supermileage/UrbanMotorControllerPCB/Urban MC.step

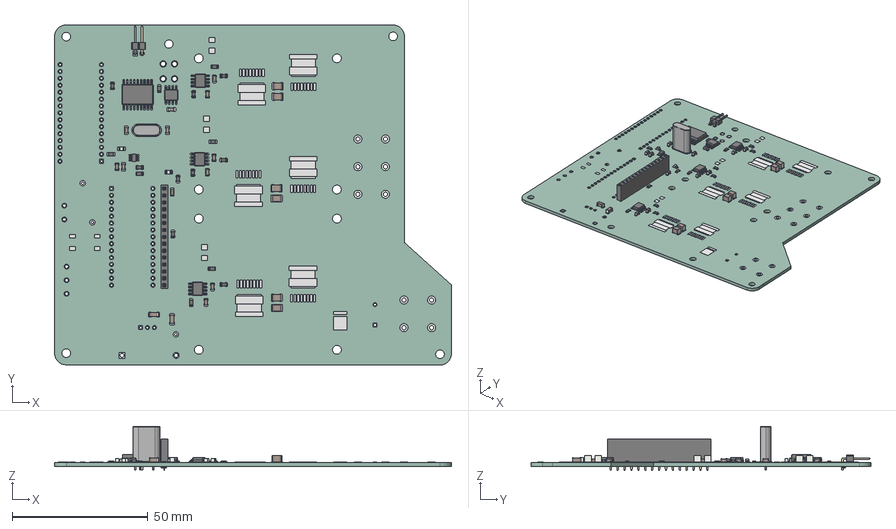
[picture p1: CAD file, 2026-01-06]
Urban MC.step
146.1 x 125.2 x 16.2 mm
C_0805_2012Metric x 12
R_0805_2012Metric x 17
Crystal_HC49-U_Vertical
C_1210_3225Metric x 6
PinHeader_1x02_P2.54mm_Horizontal
SOIC-8_3.9x4.9mm_P1.27mm x 4
SOIC-18W_7.5x11.6mm_P1.27mm
PinSocket_1x15_P2.54mm_Vertical
LED_0805_2012Metric x 2
C_1206_3216Metric x 2
SOT-23-6
Urban MC_pad
Urban MC_PCB
