supermileage/UrbanMotorControllerPCB/Urban MC.kicad_pcb

## KiCad design Urban MC.kicad_pcb (2026-10-03)

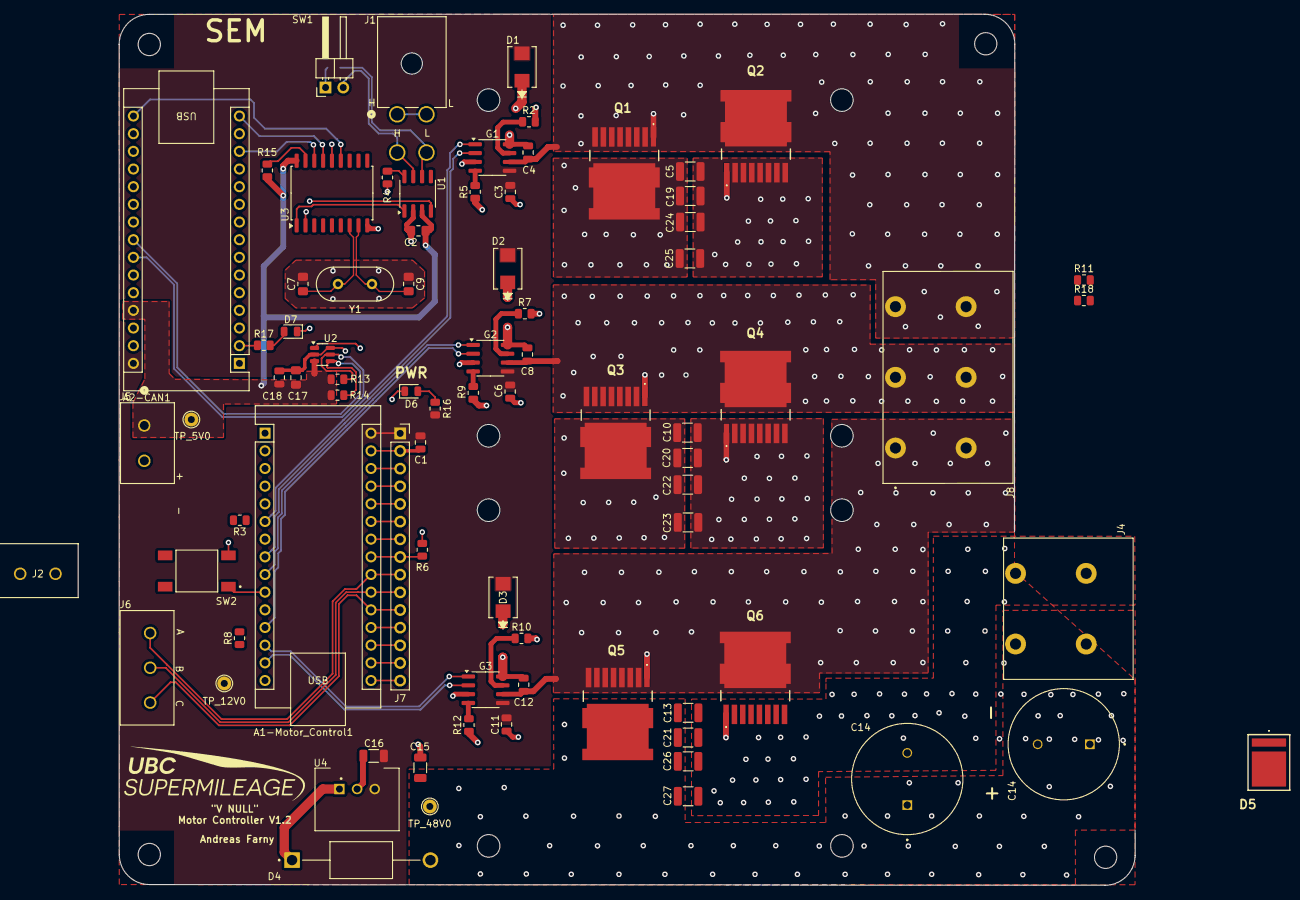
[picture p2: board Urban MC.kicad_pcb from above]

Board: 6 copper layers, 146.1 x 125.2 mm, 83 parts (1 on the bottom side), 66 nets.

Parts:
A1-Motor_Control1, A2-CAN1: Arduino_Nano_v2.x; Arduino_Nano
C1, C3, C6, C8, C11, C12, C18: 10u; C_0805_2012Metric
C2, C17: 0.1uF; C_0805_2012Metric_Pad1.18x1.45mm_HandSolder
C4: 1u; C_0805_2012Metric
C5, C10, C13: 100 nF; C_1210_3225Metric
C7, C9: 16pF; C_0805_2012Metric_Pad1.18x1.45mm_HandSolder
C14, C14#2: 1m; CAPPRD750W80D1600H2500
C15: 1u; C_1206_3216Metric
C16: 22u; C_1206_3216Metric
C19, C20, C21: 1 uF; C_1210_3225Metric
C22, C24, C26: 4.7 uF; C_1210_3225Metric
C23, C25, C27: 10 uF; C_1210_3225Metric
D1, D2, D3: D; DIODE_DO214AA_MBRS_VIS
D4: D; DIOAD1990W125L900D530
D5: D_TVS; PTVS1058CH
D6, D7: LED; LED_0805_2012Metric
G1, G2, G3: IRS2186; SOIC-8_3.9x4.9mm_P1.27mm
HEATSINK: HEATSINK-518-95AB
HEATSINK#2: HEATSINK-518-95AB
J1: CAN; CONN_5569-04A_MOL
J2: UART_DYNO; CONN_OSTTC022162_OST
J4: VBAT; TE_1-1986660-2
J5: PWR_HALL; CONN_OSTTC022162_OST
J6: HALL_SENSORS; CONN_OSTTC030162_OST
J7: Conn_01x15_Socket; PinSocket_1x15_P2.54mm_Vertical
J8: Conn_02x03_CUSTOM; TE_1986660-3
Q1, Q2, Q3, Q4, Q5, Q6: NTBLS0D8N08XTXG; NVBLS1D1N08H
R1: 120; R_0805_2012Metric
R2, R5, R7, R9, R10, R12: 11Ω; R_0805_2012Metric
R3, R8, R11, R18: 0Ω; R_0805_2012Metric
R4, R15: 10k; R_0805_2012Metric
R6, R13, R14: 10K; R_0805_2012Metric
R16: 4.7k; R_0805_2012Metric
R17: 1.5k; R_0805_2012Metric
SW1: CAN_TERM; PinHeader_1x02_P2.54mm_Horizontal
SW2: SW_MEC_5E; SW_TS04-66-70-BK-160-SMT
TP_5V0, TP_12V0, TP_48V0: TestPoint; TestPoint_THTPad_D2.0mm_Drill1.0mm
U1: MCP2561/2; SOIC-8_3.9x4.9mm_P1.27mm
U2: MCP4725; SOT-23-6
U3: MCP2515-xSO; SOIC-18W_7.5x11.6mm_P1.27mm
U4: CONV_LCW78_12-1.0
Y1: 8MHz; Crystal_HC49-U_Vertical

Connections:
3.3V_OUT: A1-Motor_Control1.17 (3V3), J7.14
5V_OUT: A1-Motor_Control1.27 (+5V), J7.4
+5V: A2-CAN1.27 (+5V), C2.2, C17.1, C18.1, J5.1, R13.1, R14.1, R15.2, TP_5V0.1, U1.3 (VDD), U2.3 (VDD), U3.18 (VDD)
+12V: A1-Motor_Control1.30 (VIN), A2-CAN1.30 (VIN), C1.1, C3.2, C6.2, C11.2, C16.2, D1.2, D2.2, D3.2, G1.5 (VCC), G2.5 (VCC), G3.5 (VCC), J7.1, R16.1, TP_12V0.1, U4.3 (+VOUT)
+48V: C5.1, C10.1, C13.1, C14.1, C15.1, C19.1, C20.1, C21.1, C22.1, C23.1, C24.1, C25.1, C26.1, C27.1, D4.A, D5.2 (A2), J4.1_1 (Pin_1), J4.1_2 (Pin_2), Q1.9 (D), Q1.10 (D_2), Q1.11 (D_3), Q1.12 (D_4), Q3.9 (D), Q3.10 (D_2), Q3.11 (D_3), Q3.12 (D_4), Q5.9 (D), Q5.10 (D_2), Q5.11 (D_3), Q5.12 (D_4), TP_48V0.1
/A4: A2-CAN1.23 (A4), R14.2, U2.4 (SDA)
/A5: A2-CAN1.24 (A5), R13.2, U2.5 (SCL)
/CAN HIGH: J1.3, SW1.2, U1.7 (CANH)
/CAN LOW: J1.4, R1.1, U1.6 (CANL)
/CAN LOW TERM: R1.2, SW1.1
A0: A1-Motor_Control1.19 (A0), J7.12
A5_MC: A1-Motor_Control1.24 (A5), J7.7
A7: A1-Motor_Control1.26 (A7), J7.5
AREF: A1-Motor_Control1.18 (AREF), J7.13
C+: C7.2, U3.7 (OSC2), Y1.1
C-: C9.2, U3.8 (OSC1), Y1.2
CS: A2-CAN1.13 (D10), U3.16 (~CS)
D13: A1-Motor_Control1.16 (D13), J7.15
GND: A1-Motor_Control1.4 (GND), A1-Motor_Control1.29 (GND), A2-CAN1.4 (GND), A2-CAN1.29 (GND), C1.2, C2.1, C3.1, C5.2, C6.1, C7.1, C9.1, C10.2, C11.1, C13.2, C14.2, C15.2, C16.1, C17.2, C18.2, C19.2, C20.2, C21.2, C22.2, C23.2, C24.2, C25.2, C26.2, C27.2, D5.1 (A1), D6.1 (K), D7.1 (K), G1.3 (COM), G2.3 (COM), G3.3 (COM), J1.1, J1.2, J4.2_1 (Pin_3), J4.2_2 (Pin_4), J5.2, J7.2, Q2.2 (S_1), Q2.3 (S_2), Q2.4 (S_3), Q2.5 (S_4), Q2.6 (S_5), Q2.7 (S_6), Q2.8 (S_7), Q4.2 (S_1), Q4.3 (S_2), Q4.4 (S_3), Q4.5 (S_4), Q4.6 (S_5), Q4.7 (S_6), Q4.8 (S_7), Q6.2 (S_1), Q6.3 (S_2), Q6.4 (S_3), Q6.5 (S_4), Q6.6 (S_5), Q6.7 (S_6), Q6.8 (S_7), R4.2, R6.2, SW2.3 (K), U1.2 (VSS), U2.2 (VSS), U2.6 (A0), U3.9 (VSS), U4.2 (GND)
HALL A: A1-Motor_Control1.22 (A3), J6.3, J7.9
HALL B: A1-Motor_Control1.21 (A2), J6.2, J7.10
HALL C: A1-Motor_Control1.20 (A1), J6.1, J7.11
HIN_1: A1-Motor_Control1.2 (D0/RX), G1.1 (HIN)
HIN_2: A1-Motor_Control1.1 (D1/TX), G2.1 (HIN)
HIN_3: A1-Motor_Control1.12 (D9), G3.1 (HIN)
LIN_1: A1-Motor_Control1.9 (D6), G1.2 (LIN)
LIN_2: A1-Motor_Control1.6 (D3), G2.2 (LIN)
LIN_3: A1-Motor_Control1.25 (A6), G3.2 (LIN), J7.6
unnamed: A1-Motor_Control1.5 (D2), R3.1
unnamed: A1-Motor_Control1.10 (D7), SW2.1
unnamed: A1-Motor_Control1.13 (D10), R8.1
unnamed: A2-CAN1.2 (D0/RX), R17.1
unnamed: D6.2 (A), R16.2
unnamed: D7.2 (A), R17.2
unnamed: G1.7 (HO), R2.1
unnamed: G1.4 (LO), R5.1
unnamed: C4.2, D1.1, G1.8 (VB)
unnamed: G2.7 (HO), R7.1
unnamed: G2.4 (LO), R9.1
unnamed: C8.2, D2.1, G2.8 (VB)
unnamed: G3.7 (HO), R10.1
unnamed: G3.4 (LO), R12.1
unnamed: C12.2, D3.1, G3.8 (VB)
unnamed: Q1.1 (G), R2.2
unnamed: Q2.1 (G), R5.2
unnamed: Q3.1 (G), R7.2
unnamed: Q4.1 (G), R9.2
unnamed: Q5.1 (G), R10.2
unnamed: Q6.1 (G), R12.2
unnamed: R4.1, U1.8 (Rs)
unnamed: R11.1, U3.2 (RXCAN)
unnamed: R18.1, U3.1 (TXCAN)
unnamed: R15.1, U3.17 (~RESET)
unnamed: D4.C, U4.1 (+VIN)
PHASE 1 OUTPUT: C4.1, G1.6 (VS), J8.3_1, J8.3_2, Q1.2 (S_1), Q1.3 (S_2), Q1.4 (S_3), Q1.5 (S_4), Q1.6 (S_5), Q1.7 (S_6), Q1.8 (S_7), Q2.9 (D), Q2.10 (D_2), Q2.11 (D_3), Q2.12 (D_4)
PHASE 2 OUTPUT: C8.1, G2.6 (VS), J8.2_1, J8.2_2, Q3.2 (S_1), Q3.3 (S_2), Q3.4 (S_3), Q3.5 (S_4), Q3.6 (S_5), Q3.7 (S_6), Q3.8 (S_7), Q4.9 (D), Q4.10 (D_2), Q4.11 (D_3), Q4.12 (D_4)
PHASE 3 OUTPUT: C12.1, G3.6 (VS), J8.1_1, J8.1_2, Q5.2 (S_1), Q5.3 (S_2), Q5.4 (S_3), Q5.5 (S_4), Q5.6 (S_5), Q5.7 (S_6), Q5.8 (S_7), Q6.9 (D), Q6.10 (D_2), Q6.11 (D_3), Q6.12 (D_4)
RESET: A1-Motor_Control1.28 (~RESET), J7.3
RXCAN: R8.2, R11.2, U1.4 (RXD)
SCK: A2-CAN1.16 (D13), U3.13 (SCK)
SI: A2-CAN1.14 (D11), U3.14 (SI)
SO: A2-CAN1.15 (D12), U3.15 (SO)
THROTTLE: A1-Motor_Control1.23 (A4), J7.8, R6.1, U2.1 (VOUT)
TXCAN: R3.2, R18.2, U1.1 (TXD)
UART_DYNO_RX: A1-Motor_Control1.7 (D4), J2.1
UART_DYNO_TX: A1-Motor_Control1.8 (D5), J2.2
