supermileage/UrbanMotorControllerPCB/(commit log)

2024-10-12 added footprints and datasheets
2024-10-19 updated LCW footprint to match size
    [LCW78_12-0.5.step, Urban MC.kicad_pcb, Urban MC.kicad_sch]
2024-10-26 Updated footprint for schematic
    [Urban MC.kicad_sch]
2024-11-02 pls work
    [Urban MC.kicad_sch]
2024-11-16 custom footprint for MOSFETs
    [PG-TO247-3-901_INF.step, Urban MC.kicad_pcb, Urban MC.kicad_sch]
2024-11-16 added custom footprints
    [436500200.stp, 436500300.stp, Download_STP_7461100_rev1.stp, Urban MC.kicad_pcb, Urban MC.kicad_sch]
2024-11-17 updated schematic
    [Urban MC.kicad_pcb, Urban MC.kicad_sch]
2024-11-23 Added diodes
    [Urban MC.kicad_sch]
2024-11-30 Updated mosfet symbol
    [IQE022N06LM5CGSCATMA1_3D.stp, Urban MC.kicad_pcb, Urban MC.kicad_sch]
2024-11-30 Updated layout
    [Urban MC.kicad_pcb]
2024-12-02 updated schematic and layout
    [SR1204.step, SSB44.step, Urban MC.kicad_pcb, Urban MC.kicad_sch]
2025-01-04 Updated Connectors from Metal Screw to Screw Terminal
    [TE_1-1986660-2.step, TE_Connectivity_1_1986660-3.step, Urban MC.kicad_pcb, Urban MC.kicad_sch]
2025-01-04 MOSFET section draft
    [Urban MC.kicad_pcb]
2025-01-06 MOSFETsection with some changes
    [Urban MC.kicad_pcb, Urban MC.kicad_sch]
2025-01-11 ready for mosfet feedback
    [Urban MC.kicad_pcb]
2025-01-11 symbol changes and filled zone solution, still looking for more feedback
    [Urban MC.kicad_pcb, Urban MC.kicad_sch]
2025-01-18 duplicated mosfet section with connected filled zones
    [Urban MC.kicad_pcb]
2025-01-19 organized fet arduino circuit components
    [Urban MC.kicad_pcb]
2025-01-22 CAN circuit and voltage regulator first draft, mounting holes
    [Urban MC.kicad_pcb]
2025-01-22 small trace edits
    [Urban MC.kicad_pcb]
2025-01-27 in the middle of layout changes- expanding right side and drawing gate driver traces
    [Urban MC.kicad_pcb, Urban MC.kicad_sch]
2025-01-30 filledempty space with filled zones, grounded components
    [Urban MC.kicad_pcb]
2025-02-01 Duplicated filled zones, finished CAN section, organized component labels
    [Urban MC.kicad_pcb]
2025-02-01 connector labels
    [Urban MC.kicad_pcb]
2025-02-01 final edits: power 12V islands, adjusting vias to pass DRC
    [Urban MC.kicad_pcb]
2025-02-02 post design review
    [Urban MC.kicad_pcb]
2025-02-05 grounding components with vias instead of long traces, 5V filled zone and MCP4725 complementary components
    [Urban MC.kicad_pcb, Urban MC.kicad_sch]
2025-02-06 Phase output net names, keepouts on mounting holes, logo, other small fixes
    [Urban MC.kicad_pcb, Urban MC.kicad_sch]
2025-02-07 5V filled zone edits
    [Urban MC.kicad_pcb, Urban MC.kicad_sch]
2025-02-08 all datasheets except CAN TERM and crystal
    [Urban MC.kicad_pcb, Urban MC.kicad_sch]
2025-02-08 making room to flash to A2
    [Urban MC.kicad_pcb]
2025-02-08 heatsinks, ready for design review
    [Urban MC.kicad_pcb, Urban MC.kicad_sch]
2025-02-09 small changed from design review: hallpower is an OUTPUT
    [Urban MC.kicad_pcb]
2025-02-10 Test points, fixed footprint warnings, logo, and fabrication files
    [Urban MC.kicad_pcb, Urban MC.kicad_sch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]
2025-02-11 complete output files
    [Urban MC-B_Cu.gbr, Urban MC-B_Mask.gbr, Urban MC-B_Paste.gbr, Urban MC-B_Silkscreen.gbr, Urban MC-Edge_Cuts.gbr, Urban MC-F_Cu.gbr, Urban MC-F_Mask.gbr, Urban MC-F_Paste.gbr]
2025-02-11 Silkscreen edits, redone Gerbers
    [Urban MC-B_Cu.gbl, Urban MC-B_Mask.gbs, Urban MC-B_Paste.gbp, Urban MC-B_Paste.gbr, Urban MC-B_Silkscreen.gbo, Urban MC-B_Silkscreen.gbr, Urban MC-Edge_Cuts.gm1, Urban MC-F_Cu.gtl]
2025-02-11 Gerber and silkscreen edits
    [Urban MC-B_Cu.gbl, Urban MC-B_Mask.gbs, Urban MC-B_Paste.gbp, Urban MC-B_Silkscreen.gbo, Urban MC-Edge_Cuts.gm1, Urban MC-F_Cu.gtl, Urban MC-F_Mask.gts, Urban MC-F_Paste.gtp]
2025-02-11 zipped Gerber
2025-02-11 more silkscreen edits
    [Urban MC-B_Cu.gbl, Urban MC-B_Mask.gbs, Urban MC-B_Paste.gbp, Urban MC-B_Silkscreen.gbo, Urban MC-Edge_Cuts.gm1, Urban MC-F_Cu.gtl, Urban MC-F_Mask.gts, Urban MC-F_Paste.gtp]
2025-03-07 lager pads for J3, J4
    [Urban MC.kicad_pcb]
2025-03-08 slightly smaller pads for J3, J4 to pass DRC
    [Urban MC.kicad_pcb]
2025-03-09 CAN connector changes
    [Urban MC.kicad_pcb, Urban MC.kicad_sch]
2025-03-09 V1.1 ORDERED
    [Urban MC-B_Cu.gbl, Urban MC-B_Mask.gbs, Urban MC-B_Paste.gbp, Urban MC-B_Silkscreen.gbo, Urban MC-Edge_Cuts.gm1, Urban MC-F_Cu.gtl, Urban MC-F_Mask.gts, Urban MC-F_Paste.gtp]
2025-09-07 schematic cleanup
    [Urban MC.kicad_pcb, Urban MC.kicad_sch]
2025-09-26 Schematic cleanup and start of big layout changes
    [Urban MC.kicad_pcb]
2025-10-06 Layout almost complete, just need to add vias
    [Urban MC.kicad_pcb, Urban MC.kicad_sch]
2025-10-07 peppered vias
    [Urban MC.kicad_pcb]
2025-10-13 design review changes in progress
    [Urban MC.kicad_pcb, Urban MC.kicad_sch]
2025-10-17 Design Review Changes (WIP)
    [Urban MC.kicad_pcb, Urban MC.kicad_sch]
2025-10-22 all post-design review changes except vias
    [Urban MC.kicad_pcb, Urban MC.kicad_sch]
2025-10-24 Final Review before order
    [Urban MC-B_Cu.gbl, Urban MC-B_Mask.gbs, Urban MC-B_Paste.gbp, Urban MC-B_Silkscreen.gbo, Urban MC-Edge_Cuts.gm1, Urban MC-F_Cu.gtl, Urban MC-F_Mask.gts, Urban MC-F_Paste.gtp]
2025-11-01 V1.2 ORDERED VERSION
    [Urban MC-B_Cu.gbl, Urban MC-B_Mask.gbs, Urban MC-B_Paste.gbp, Urban MC-B_Silkscreen.gbo, Urban MC-Edge_Cuts.gm1, Urban MC-F_Cu.gtl, Urban MC-F_Mask.gts, Urban MC-F_Paste.gtp]
2025-11-16 D1-3 BOM change
    [Urban MC.kicad_pcb, Urban MC.kicad_sch]
2026-01-06 V1.2 STEP file 1
    [436500200.stp, 436500300.stp, Download_STP_7461100_rev1.stp, IQE022N06LM5CGSCATMA1_3D.stp, LCW78_12-0.5.step, PG-TO247-3-901_INF.step, SR1204.step, SSB44.step]
2026-08-21 2026-2027 initial fixes from V1.2
    [Urban MC.kicad_sch]
2026-08-21 Stop tracking KiCad backups, autosaves, and lock files
2026-08-25 Added opamp network not connected yet
    [Urban MC.kicad_sch]
2026-09-23 add new sch sheet
    [inverter_stage.kicad_sch]
2026-09-23 Schematic Organization
    [Urban MC.kicad_sch]
2026-10-03 add new micro symbol and footprint
    [Urban MC.kicad_pcb, Urban MC.kicad_sch]
